Ashwin-Rajesh/fpga_functiongen/vivado_function_gen/vivado_function_gen.runs/impl_1/.init_design.begin.rst

<?xml version="1.0"?>
<ProcessHandle Version="1" Minor="0">
    <Process Command=".planAhead." Owner="ashwin" Host="" Pid="322003">
    </Process>
</ProcessHandle>
