Ashwin-Rajesh/fpga_functiongen/vivado_function_gen/vivado_function_gen.runs/synth_1/.vivado.begin.rst

<?xml version="1.0"?>
<ProcessHandle Version="1" Minor="0">
    <Process Command="vivado" Owner="ashwin" Host="" Pid="321334" HostCore="12" HostMemory="16259904">
    </Process>
</ProcessHandle>
