Ashwin-Rajesh/fpga_functiongen/report.pdf

# A multi-channel configurable sinusoidal waveform generator using CORDIC

Ashwin Rajesh (Sr. No 21519) M.Tech Microelectronics and VLSI Design

Indian Institute of Science, Bangalore

Abstract— This report for the course project for the “Digital System Design for FPGA” course by prof. Kuruvilla Varghese documents a time-multiplexed sinusoidal wave generator that uses the CORDIC algorithm to generate sinusoidal waves of variable frequency, amplitude and offset. The system was tested on the Basys3 board.

I. INTRODUCTION
CORDIC (COordinate Rotation DIgital Computer) is an algorithm for efficiently computing the rotation and inverse rotation on fixed point inputs using shift and
add/subtract | operations. | It | avoids | using | any
multiplication or division making it very efficient in terms of resource utilization and speed.

Here, a sinusoidal waveform generator is developed that uses the CORDIC algorithm to generate a sinusoidal wave with variable frequency, gain and DC offset. The CORDIC core is time-multiplexed to enable multiple channels to share the hardware to generate independent sinusoidal waves. All key parameters of the core including phase and value register widths, number of iterations and output value width is reconfigurable.

The system is integrated and tested on a Basys3 FPGA board with a dual channel DAC.

II. PROBLEM STATEMENT
Design a Sine waveform generator using CORDIC algorithm. You can choose the architecture you want and decide on constraints(E.g.,Min Resources/ Max frequency of waveform etc).

Considering the problem statement, maximum bandwidth was chosen as the optimization criteria. However, in the final integrated system, the serial communication of the DAC imposes a major bottleneck preventing maximum utilization of this bandwidth.

III. ALGORITHM
The CORDIC algorithm implements a 2D rotation to rotate an X and Y input by an arbitrary angle. It attempts to approximate the 2D rotation by using a combination of certain fixed “micro-rotations”. These angles are specifically chosen such that they can be implemented by shifts rather than multiplications since certain elements in the matrix become inverse powers of two.

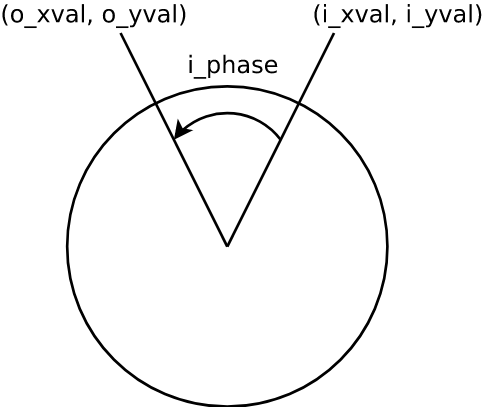
[picture p2: figure]

Fig. 1: CORDIC problem statement
A. CORDIC algorithm
A 2D rotation essentially comprises of multiplication of a 2D vector (with X and Y coordinates) with a 2D matrix, R(θ) as shown in Fig 2.

Fig. 2: 2D rotation matrix for angle θ
The core idea in CORDIC is to choose angle such that tan(θ) is a power of two. Now, taking the cos(θ) outside and taking tan(θ) = 2

-k
. This matrix and its equation implemented using shifts is shown in Fig. 3. This operation does a rotation by tan

-1
(2

-k
)

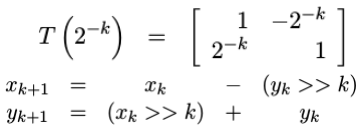
[picture p3: figure]

Fig. 3: Micro-rotaion matrix and equation
However, the cos(θ) term is not considered here. This comes up as a “scaling factor” in the rotation rotation matrix which comes up to be 1 + 2 . This matrix can
−2k
be easily converted to a rotation by -θ instead of θ by inverting the signs of the shifted terms (sine terms) in the matrix. The final positive and negative rotation matrices are shown in Fig. 4.
E3 231: Digital System Design for FPGAs project, May 2023 | Pg.no 1

Fig. 3: Micro-rotaion matrix and equation

The CORDIC algorithm uses multiple such rotations in either the positive or negative direction to implement the net rotation. The direction of rotation depends on the angle left to be rotated to reach the required angle. 3 variables are required, x, y and phase. The direction is decided based on the previous value of phase. The x and y registers are updated based on the equation in Fig. 3. The angle is updated by incrementing or decrementing tan

-1
(2

-k
) which is stored in a look-up table for each iteration, k.

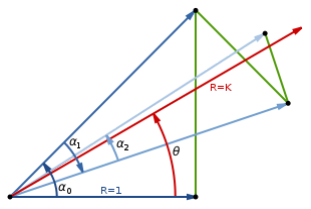
[picture p4: figure]

Fig. 4: CORDIC micro-rotations

The scaling factor is handled by using an initial x value of inverse of the products of all the individual scaling factors (and y = 0), so that final amplitude becomes 1.

B. Pre-rotation
The CORDIC algorithm converges only when the input rotation angle is between -100

o and 100

o
. To
cicumvent this limitation, we perform a pre-rotation before CORDIC. This pre-rotation brings all rotations by any angle from -180

o
to 180

o
into a rotation by an angle from -45

o
to 45

o
. This range can be achieved even without the first CORDIC rotation, and hence the iterations start from k = 2. The pre-rotation scheme is shown in Fig. 5.

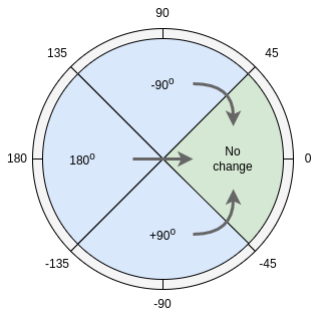
[picture p5: figure]

Fig. 5: CORDIC pre-rotation

Each 90 or 180 degree rotation is done by changing the signs and/or exchanging the x and y inputs.

IV. ARCHITECTURE
The architecture was designed for opimized bandwidth using a pipelined architecture. Each CORDIC titration is one stage in the pipeline. The high bandwidth can be used for time-multiplexing n number of channels on the same CORDIC core with each channel getting 1/n of the original bandwidth.
A. Number representation
All the values in CORDIC are represented using signed fixed point representation. This is represented as Qn.m where n is the number of integer bits and m is the number of fractional bits. The number representations is shown in Fig. 6.

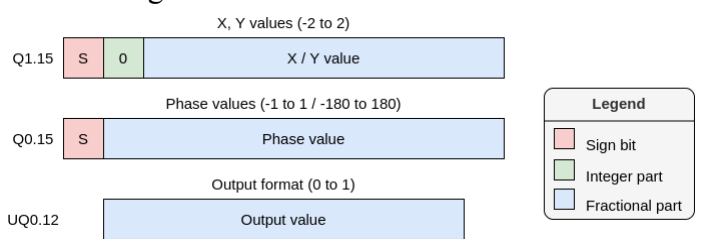
[picture p6: figure]

Fig. 6: Number representation
UQn.m represents unsigned fixed point format. The X and Y values have one integer bit to handle overflows because of the scaling factor. The phase is represented as -1 to 1 with -1 mapped to -180

o and 1 mapped to 180

o
. It
can also be interpreted as a UQ0.16 format from 0 to 1 with 1 representing 360

o because of the way 2s
complement representation works. The output is an unsigned value from 0 to 1. This can be directly given to a single-ended DAC.
B. Wavegenerator architecture
The wavegenerator is designed to be able to produce any sinusoidal waveform as required by using several configuration inputs. Following are the inputs to the wavegen for each channel. The widths of all inputs are parameterized, but the implemented widths are shown.

TABLE I: WAVEGENERATOR INPUTS
Input | Description
Enable | High to enable channel output
Step size[16] | Phase change made in every step
Prescaler[8] | A step is made every (n+1) number of clock cycles
Init[17] | Initial X value. Used to control amplitude
Offset[12] | Output offset value when CORDIC output is 0
E3 231: Digital System Design for FPGAs project, May 2023 | Pg.no 2

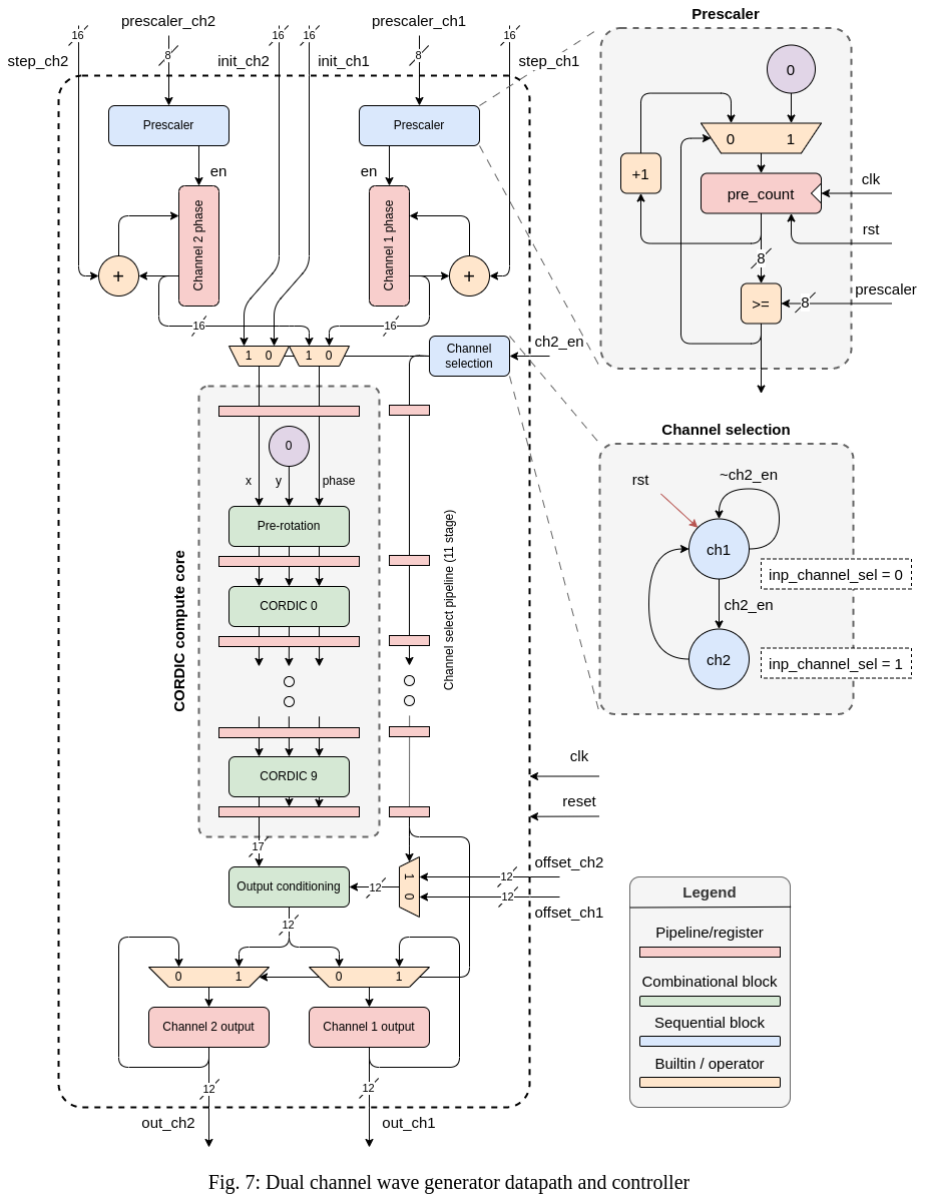
[picture p7: figure]

Hardware testing was done on a dual channel wave generator. However, a design was also made with a parameterizable number of channels. Hereafter for simplicity, unless mentioned otherwise, we will be concerned with the design of a dual channel wave generator with 16 bit value and phase registers, 12 bit output register and an 8 bit prescaler.

The datapath of a dual channel wave generator is shown in Fig. 7. Reset and clock inputs are assumed to be fed to all registers and sequential blocks. All registers are initialized to 0. It is assumed that channel 1 is always enabled and channel 2 is disabled when channel 1 bandwidth needs to be increased. An n-channel wave generator would have a similar structure but the channel selection controller would be a n-channel round-robin scheduler.

The CORDIC compute blocks implement the equations in Fig. 3. Each of them also stores the angle rotated in that iteration to modify the phase remainder value. Theese angle values (tan

-1
(2

-k
)) are generated
automatically during synthesis to enable generation of wave generators for any number of iterations and arbitrary phase resolution.
E3 231: Digital System Design for FPGAs project, May 2023 | Pg.no 3

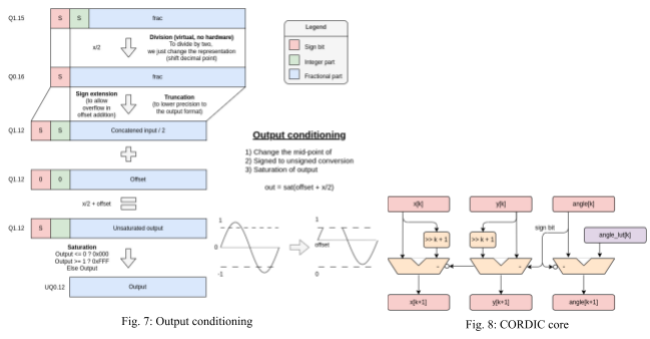
[picture p8: figure]

The output conditioning circuit implements the offset and saturation of the CORDIC output to convert it into a well behaved unsigned number that can be fed to a DAC. The steps for doing this is shown in Fig. 8.
To generate a sinusoidal waveform of a required frequency, the following equation is used.

Output frequency =

Clock frequency x Step size 2

N
x (Prescaler + 1)

Where N is the width of the phase register (16 here).

V. DESIGN SPACE EXPLORATION
There are multiple parameters for the CORDIC core which can be tweaked to get the required balance
between | accuracy, | speed/latency | and | resource
consumption. The parameters are shown in Table II.

The latency is proportional to ITER and indirectly on VW and PW since they increase the adder widths which can decrease frequency if they form part of the critical path. The resource utilization can be approximated as a product of PW, VW and ITER. OW and DW only decide the prescaler and output saturation region widths and their impact can be neglected compared to the other factors. So, to design the system for a particular application, OW and DW are fixed and the other parameters are optimized depending on the required performance, resource utilization and accuracy. PW can also be fixed since it decides the output frequency relationship and the resolution of input phase.

TABLE I: MODULE PARAMETERS
Param | Name | Description
PW | Phase Width | Width of phase registers (and step size)*
VW | Value width | Width of x and y registers (without sign)
DW | Divider width | Width of prescaler*
OW | Output width | Width of output value*
ITER | Iterations | Number of CORDIC iterations
*: Total width including sign bit, int and frac parts

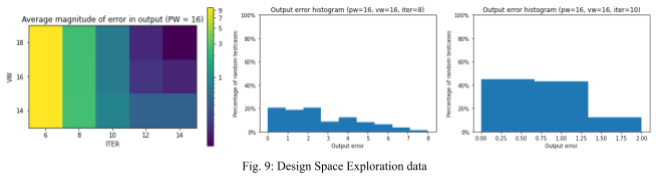
[picture p9: figure]

E3 231: Digital System Design for FPGAs project, May 2023 | Pg.no 4

This analysis was done on the dataset using an automated simulation environment. OW was fixed at 12 since the DAC available was 12 bit wide. DW was fixed at 8 arbitrarily (prescaler value of 255 was found to be sufficient) and PW is fixed at 16 to get sufficient resolution. For this combination, the error was measured. Error is measured as the difference in the output count (considering it to be an unsigned integer without any fractional part) from a reference output calculated using the $sin function in verilog.

The heatmap fo this average error v/s different VW and ITER combinations can be seen in Fig. 9. VW=16 and ITER=10 seems to be the best trade-off since the average error is almost 1 which is negligible. Number of iterations has a much higher impact than width of value register. Decreasing iteration count to 8 increases the average error above 3, as can be seen in the histograms.

VI. SYSTEM DESIGN
The wavegenerator was tested on a Basys3 FPGA board using a serial DAC. The toplevel module and the interfaces designed with the various peripherals is shown in Fig. 10.

Since 8 inputs are to be given to the wave generator, a register file and an access system was designed. The left and right push buttons are used to select the register to be accessed and the center button enters the data from the slide switches into the required register. The LEDs display which register is currently selected and the 7 segment display shows the contents of the selected display. The up button resets the whole system. All buttons were debounced.
The x_init input is 15 bit and uses the UQ0.15 representation. It is used to control the wave amplitude. The final wave amplitude is

V

ampl = V
cc

x init x 1. 1644 / 2

Where 1.1644 is the scaling factor for CORDIC (without 45

o
rotation). By default, it loads the value corresponding to 1/1.644 leading to a sine wave of Vcc / 2 amplitude and centered at Vcc / 2 (offset = 0.5). The channels output 1kHz and 2kHz waves respectively.

The DAC uses an SPI like interface with one clock pin, a chip select pin and two data pins which are latched on the negative edge of the clock. The interface is implemented using a state machine. It has 2 states and a 4-bit counter which indicates the current bit being sent. It has a start signal indicating when to start the next transmission, but this is always high to continuously send data.

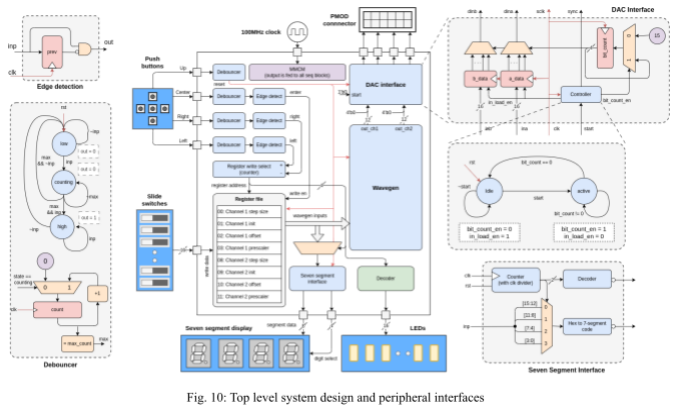
[picture p10: figure]

E3 231: Digital System Design for FPGAs project, May 2023 | Pg.no 5

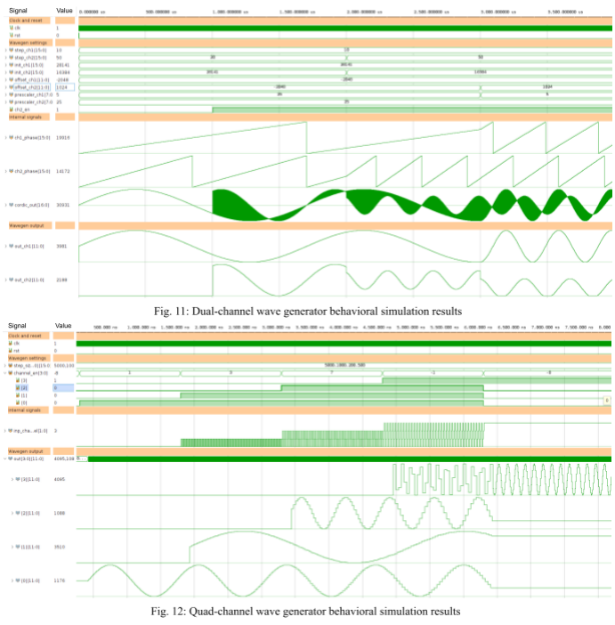
[picture p11: figure]

The DAC sends one sample every 17 cycles (16 data bits and a SYNC cycle). However, the wavegen generates a sample every cycle. This mismatch can be an issue at high frequencies. The DAC practically samples the output of the wavegenerator again, which can cause some aliasing effects.

DAC Update Rate = Clock frequency / 17

VII. SIMULATION RESULTS

Simulations were performed to verify the component at different stages. The results are shown in Fig. 11.

Different settings like step size, prescaler ratio, amplitude and offset were changed in the course of the test, as can be seen from the figure. The CORDIC output is seen as a filled waveform between the channel 1 and channel 2 outputs, when channel 2 is enabled. This is because the CORDIC output is time-multiplexed, and switches between the two channels in every cycle.

E3 231: Digital System Design for FPGAs project, May 2023 | Pg.no 6

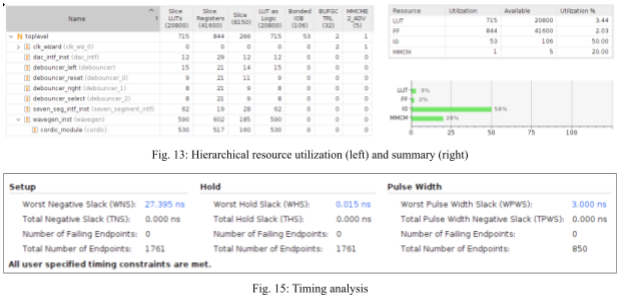
[picture p12: figure]

The n-channel wavegenerator was also tested for N=4. The switching behavior between the channels can be clearly observed. It can also be observed that on increasing the number of channels the waveform starts to become less smooth because the output sampling frequency has become ¼ times the maximum frequency.

VIII. IMPLEMENTATION RESULTS
The design was implemented on the basys3 FPGA board. The PMOD DA2 DAC used can only operate at a maximum frequency of 30MHz. So, our design was synthesized for 30MHz. The clock wizard IP was used to generate the 30MHz clock from the 100MHz clock available on the board.
A. Resource Utilization
The resource utilization is shown in Fig. 13. It can be observed that the cordic module takes up about 75% of the resources. The additional components in the wave generator consume about 8%. By multiplexing the CORDIC module, we are able to utilize the same hardware without adding significant overhead.
B. Timing and maximum frequency
The worst negative slack (WNS) is reported as 27.4ns as can be seen from Fig. 14. Our clock frequency is 30Mhz. Using this, we can find the maximum frequency at which the circuit can operate.

T

min = T

clk − WNS = 33. 33 − 27. 40 = 5. 93ns

fmax = 1/T

min = 168. 63 MHz

However, the throughput of the whole system is limited by the DAC which can only send one sample every 17 cycles. The DAC update rate is

f

DAC = 30 / 17 = 1. 77MHz
The frequency of the output waveform is limited by this update rate. The maximum output frequency depends on the number of samples required per cycle. If this is two along the lines of the nyquist sampling theorem, the maximum frequency is 1.77 / 2 = 882.85 kHz. However, a minimum of 10 samples is recommended to get a smooth waveform bringing the frequency down to 176.4 kHz.

The input setup and hold time and detailed timing analysis are given in the end.

C. Power
The net power consumption is 0.204W. About 65% of the power dissipation is dynamic with the MMCM consuming 91% of this. Logic only accounts of 4% of the dynamic delay.

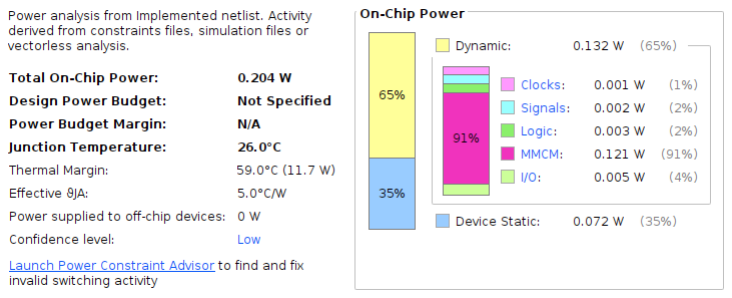
[picture p13: figure]

Fig. 16: Power analysis summary

E3 231: Digital System Design for FPGAs project, May 2023 | Pg.no 7

E3 231: Digital System Design for FPGAs project, May 2023 | Pg.no 8

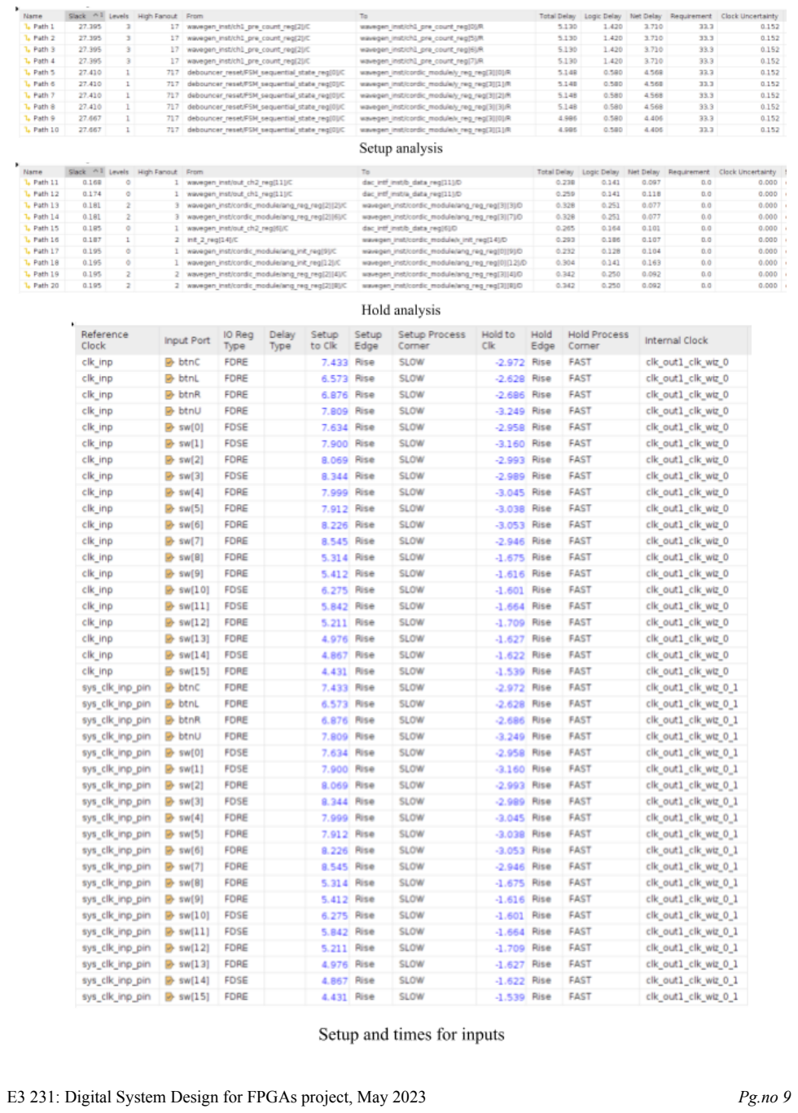
[picture p14: page 9]

E3 231: Digital System Design for FPGAs project, May 2023 | Pg.no 9

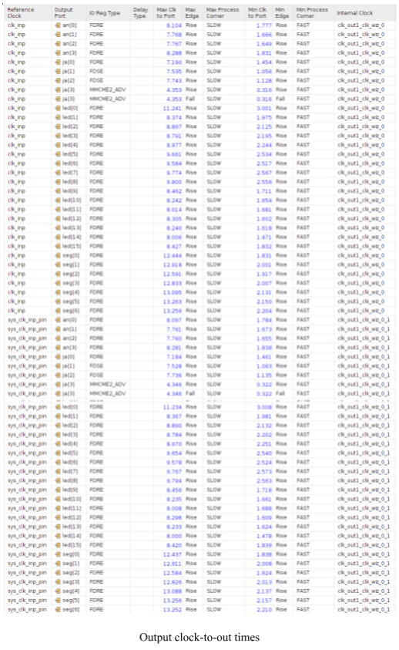
[picture p15: figure]

E3 231: Digital System Design for FPGAs project, May 2023 | Pg.no 10

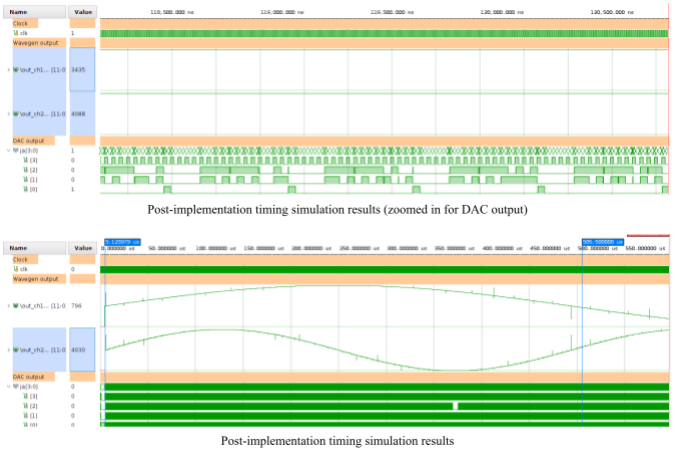
[picture p16: figure]

E3 231: Digital System Design for FPGAs project, May 2023 | Pg.no 11
