Ashwin-Rajesh/fpga_functiongen/docs/cordic_16_14_10_hist.png

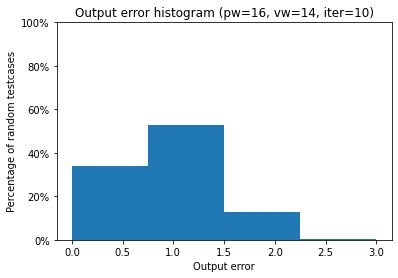
docs/cordic_16_14_10_hist.png
