Ashwin-Rajesh/fpga_functiongen/docs/cordic_16_16_8_hist.png

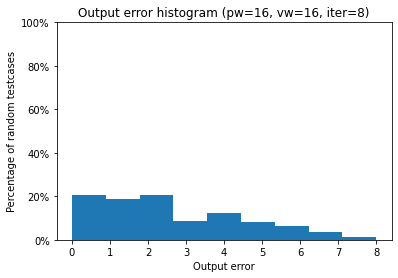
docs/cordic_16_16_8_hist.png
