Ashwin-Rajesh/fpga_functiongen/docs/cordic_16_16_10_hist.png

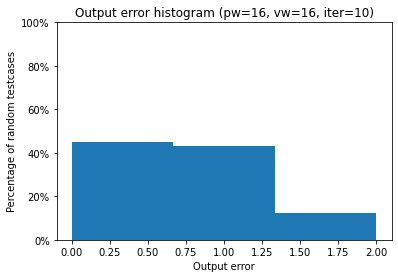
docs/cordic_16_16_10_hist.png
