Ashwin-Rajesh/fpga_functiongen/docs/cordic_16_16_12_hist.png

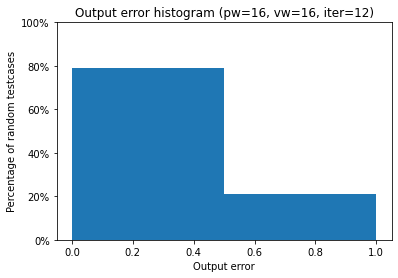
docs/cordic_16_16_12_hist.png
