Ashwin-Rajesh/fpga_functiongen/docs/cordic_core.png

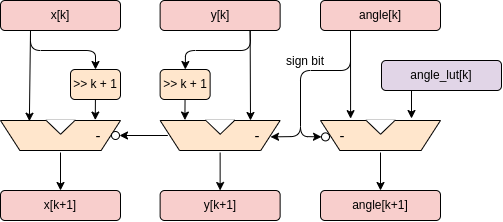
docs/cordic_core.png
