Ashwin-Rajesh/fpga_functiongen/docs/offset_addition.png

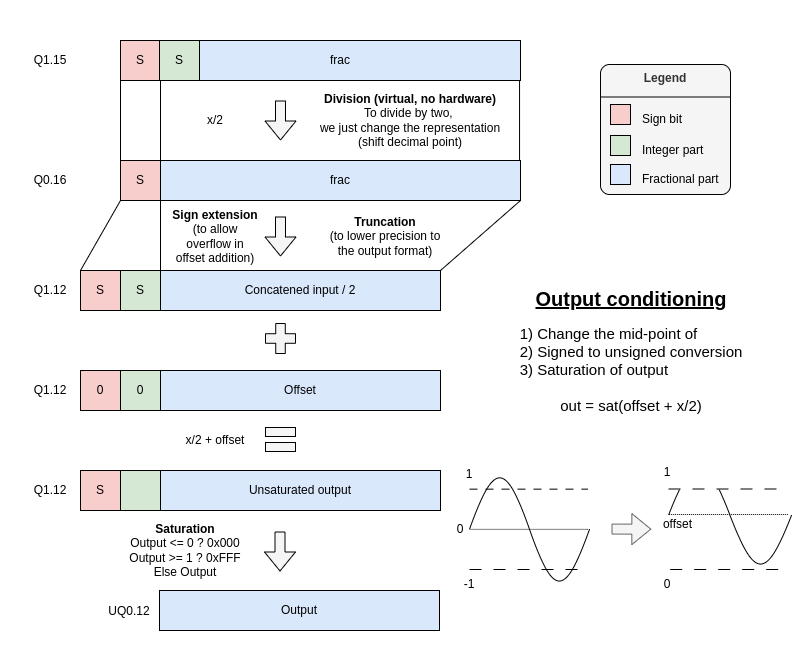
docs/offset_addition.png
