Ashwin-Rajesh/fpga_functiongen/docs/pre_rotation.png

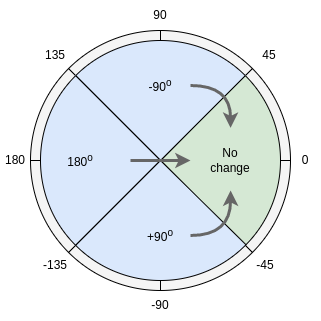
docs/pre_rotation.png
