Ashwin-Rajesh/fpga_functiongen/docs/toplevel.png

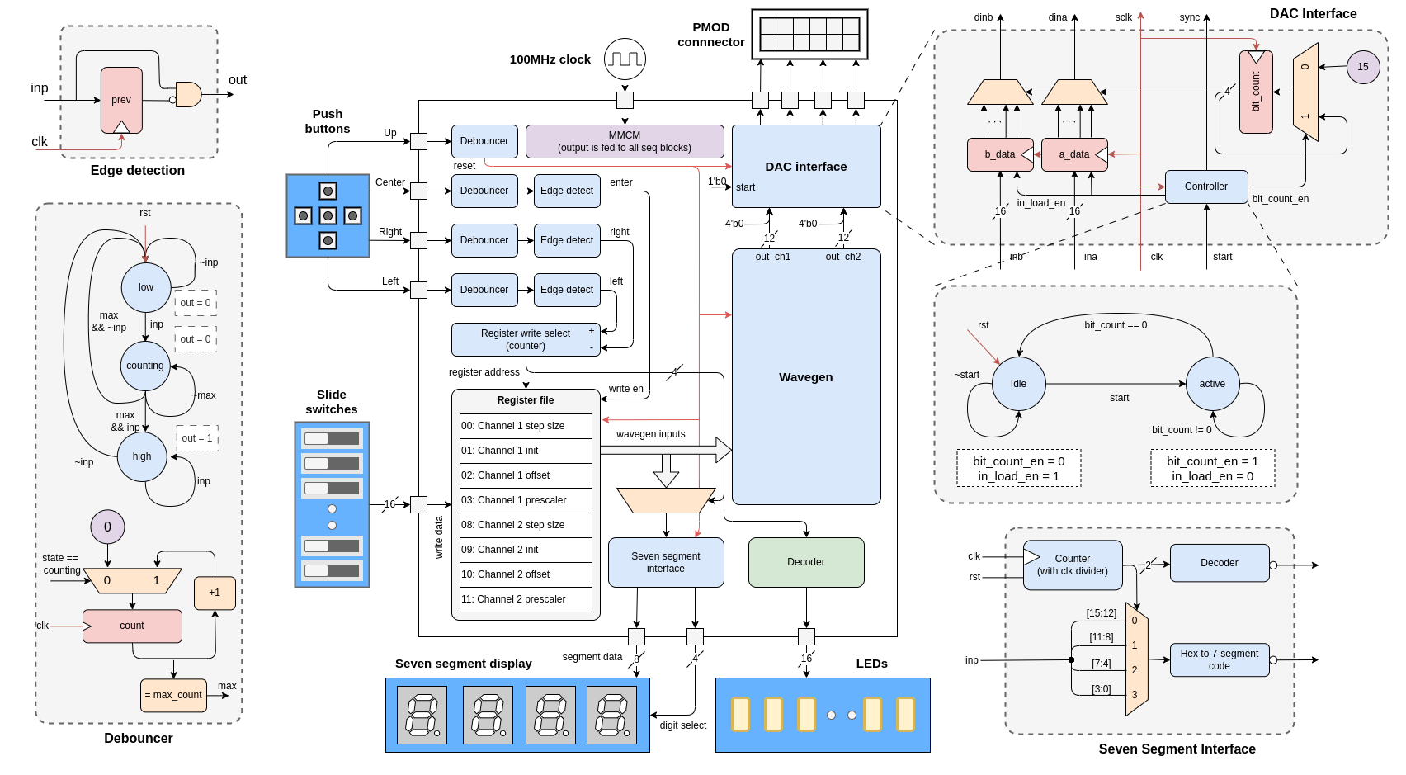
docs/toplevel.png
