Ashwin-Rajesh/fpga_functiongen/vivado_function_gen/vivado_function_gen.runs/synth_1/.Xil/toplevel_propImpl.xdc

set_property SRC_FILE_INFO {cfile:/HDD/CollegeWork/dsf/proj_cordic/proj_cordic.srcs/constrs_1/new/master.xdc rfile:../../../proj_cordic.srcs/constrs_1/new/master.xdc id:1} [current_design]
set_property src_info {type:XDC file:1 line:7 export:INPUT save:INPUT read:READ} [current_design]
set_property PACKAGE_PIN W5 [get_ports clk_inp]
set_property src_info {type:XDC file:1 line:12 export:INPUT save:INPUT read:READ} [current_design]
set_property PACKAGE_PIN V17 [get_ports {sw[0]}]
set_property src_info {type:XDC file:1 line:14 export:INPUT save:INPUT read:READ} [current_design]
set_property PACKAGE_PIN V16 [get_ports {sw[1]}]
set_property src_info {type:XDC file:1 line:16 export:INPUT save:INPUT read:READ} [current_design]
set_property PACKAGE_PIN W16 [get_ports {sw[2]}]
set_property src_info {type:XDC file:1 line:18 export:INPUT save:INPUT read:READ} [current_design]
set_property PACKAGE_PIN W17 [get_ports {sw[3]}]
set_property src_info {type:XDC file:1 line:20 export:INPUT save:INPUT read:READ} [current_design]
set_property PACKAGE_PIN W15 [get_ports {sw[4]}]
set_property src_info {type:XDC file:1 line:22 export:INPUT save:INPUT read:READ} [current_design]
set_property PACKAGE_PIN V15 [get_ports {sw[5]}]
set_property src_info {type:XDC file:1 line:24 export:INPUT save:INPUT read:READ} [current_design]
set_property PACKAGE_PIN W14 [get_ports {sw[6]}]
set_property src_info {type:XDC file:1 line:26 export:INPUT save:INPUT read:READ} [current_design]
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
set_property src_info {type:XDC file:1 line:90 export:INPUT save:INPUT read:READ} [current_design]
set_property PACKAGE_PIN U5 [get_ports {seg[4]}]
set_property src_info {type:XDC file:1 line:92 export:INPUT save:INPUT read:READ} [current_design]
set_property PACKAGE_PIN V5 [get_ports {seg[5]}]
set_property src_info {type:XDC file:1 line:94 export:INPUT save:INPUT read:READ} [current_design]
set_property PACKAGE_PIN U7 [get_ports {seg[6]}]
set_property src_info {type:XDC file:1 line:97 export:INPUT save:INPUT read:READ} [current_design]
set_property PACKAGE_PIN V7 [get_ports dp]
set_property src_info {type:XDC file:1 line:100 export:INPUT save:INPUT read:READ} [current_design]
set_property PACKAGE_PIN U2 [get_ports {an[0]}]
set_property src_info {type:XDC file:1 line:102 export:INPUT save:INPUT read:READ} [current_design]
set_property PACKAGE_PIN U4 [get_ports {an[1]}]
set_property src_info {type:XDC file:1 line:104 export:INPUT save:INPUT read:READ} [current_design]
set_property PACKAGE_PIN V4 [get_ports {an[2]}]
set_property src_info {type:XDC file:1 line:106 export:INPUT save:INPUT read:READ} [current_design]
set_property PACKAGE_PIN W4 [get_ports {an[3]}]
set_property src_info {type:XDC file:1 line:111 export:INPUT save:INPUT read:READ} [current_design]
set_property PACKAGE_PIN U18 [get_ports btnC]
set_property src_info {type:XDC file:1 line:113 export:INPUT save:INPUT read:READ} [current_design]
set_property PACKAGE_PIN T18 [get_ports btnU]
set_property src_info {type:XDC file:1 line:115 export:INPUT save:INPUT read:READ} [current_design]
set_property PACKAGE_PIN W19 [get_ports btnL]
set_property src_info {type:XDC file:1 line:117 export:INPUT save:INPUT read:READ} [current_design]
set_property PACKAGE_PIN T17 [get_ports btnR]
set_property src_info {type:XDC file:1 line:119 export:INPUT save:INPUT read:READ} [current_design]
set_property PACKAGE_PIN U17 [get_ports btnD]
set_property src_info {type:XDC file:1 line:126 export:INPUT save:INPUT read:READ} [current_design]
set_property PACKAGE_PIN J1 [get_ports {ja[0]}]
set_property src_info {type:XDC file:1 line:129 export:INPUT save:INPUT read:READ} [current_design]
set_property PACKAGE_PIN L2 [get_ports {ja[1]}]
set_property src_info {type:XDC file:1 line:132 export:INPUT save:INPUT read:READ} [current_design]
set_property PACKAGE_PIN J2 [get_ports {ja[2]}]
set_property src_info {type:XDC file:1 line:135 export:INPUT save:INPUT read:READ} [current_design]
set_property PACKAGE_PIN G2 [get_ports {ja[3]}]
