Ashwin-Rajesh/fpga_functiongen/vivado_function_gen/vivado_function_gen.gen/sources_1/ip/clk_wiz_0/clk_wiz_0_stub.v

// Copyright 1986-2020 Xilinx, Inc. All Rights Reserved.
// --------------------------------------------------------------------------------
// Tool Version: Vivado v.2020.2 (lin64) Build 3064766 Wed Nov 18 09:12:47 MST 2020
// Date        : Fri Apr 28 14:26:47 2023
// Host        : ashwin--Y540-U running 64-bit Ubuntu 22.04.1 LTS
// Command     : write_verilog -force -mode synth_stub -rename_top clk_wiz_0 -prefix
//               clk_wiz_0_ clk_wiz_0_stub.v
// Design      : clk_wiz_0
// Purpose     : Stub declaration of top-level module interface
// Device      : xc7a35tcpg236-1
// --------------------------------------------------------------------------------

// This empty module with port declaration file causes synthesis tools to infer a black box for IP.
// The synthesis directives are for Synopsys Synplify support to prevent IO buffer insertion.
// Please paste the declaration into a Verilog source file or add the file as an additional source.
module clk_wiz_0(clk_out1, clk_in1)
/* synthesis syn_black_box black_box_pad_pin="clk_out1,clk_in1" */;
  output clk_out1;
  input clk_in1;
endmodule
