Ashwin-Rajesh/fpga_functiongen/vivado_function_gen/vivado_function_gen.gen/sources_1/ip/clk_wiz_0/clk_wiz_0_stub.vhdl

-- Copyright 1986-2020 Xilinx, Inc. All Rights Reserved.
-- --------------------------------------------------------------------------------
-- Tool Version: Vivado v.2020.2 (lin64) Build 3064766 Wed Nov 18 09:12:47 MST 2020
-- Date        : Fri Apr 28 14:26:48 2023
-- Host        : ashwin--Y540-U running 64-bit Ubuntu 22.04.1 LTS
-- Command     : write_vhdl -force -mode synth_stub -rename_top clk_wiz_0 -prefix
--               clk_wiz_0_ clk_wiz_0_stub.vhdl
-- Design      : clk_wiz_0
-- Purpose     : Stub declaration of top-level module interface
-- Device      : xc7a35tcpg236-1
-- --------------------------------------------------------------------------------
library IEEE;
use IEEE.STD_LOGIC_1164.ALL;

entity clk_wiz_0 is
  Port ( 
    clk_out1 : out STD_LOGIC;
    clk_in1 : in STD_LOGIC
  );

end clk_wiz_0;

architecture stub of clk_wiz_0 is
attribute syn_black_box : boolean;
attribute black_box_pad_pin : string;
attribute syn_black_box of stub : architecture is true;
attribute black_box_pad_pin of stub : architecture is "clk_out1,clk_in1";
begin
end;
